BrownSpaceEngineering/PVDX-Comms-Hardware/Components/PCB.SMAFST.2H.A.HT/PCB.SMAFST.2H.A.HT.step

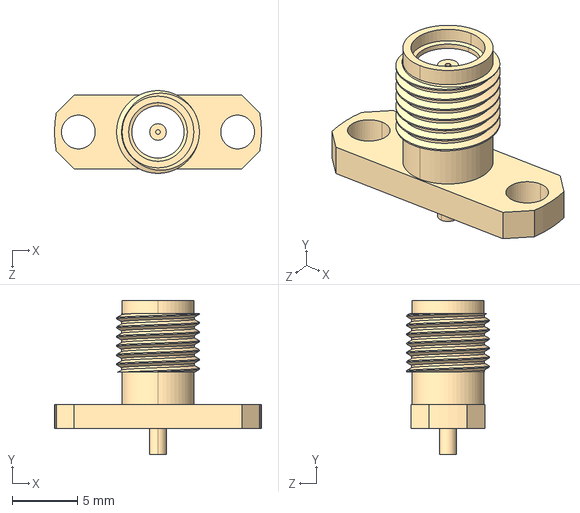
[picture p1: CAD file, 2026-09-30]
Components/PCB.SMAFST.2H.A.HT/PCB.SMAFST.2H.A.HT.step
15.9 x 11.8 x 6.35 mm
