BrownSpaceEngineering/PVDX-Comms-Hardware/Components/RBP-440+/SMD8_GP731_MNC.step

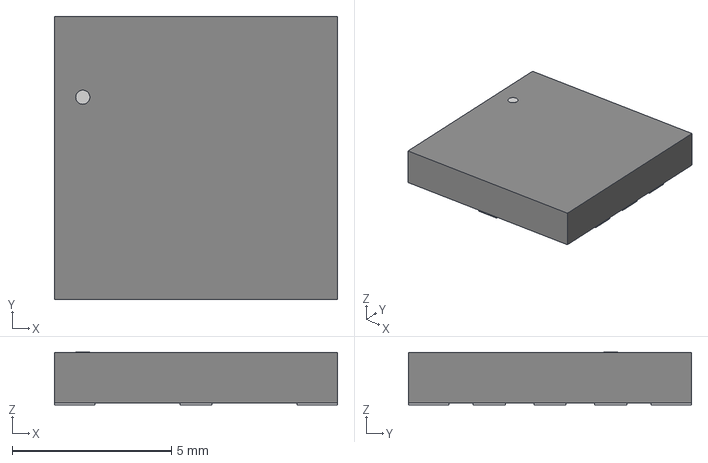
[picture p2: CAD file, 2026-10-01]
Components/RBP-440+/SMD8_GP731_MNC.step
8.89 x 8.89 x 1.65 mm
