BrownSpaceEngineering/PVDX-Comms-Hardware/AT86 Breakout/AT86 Breakout.pdf

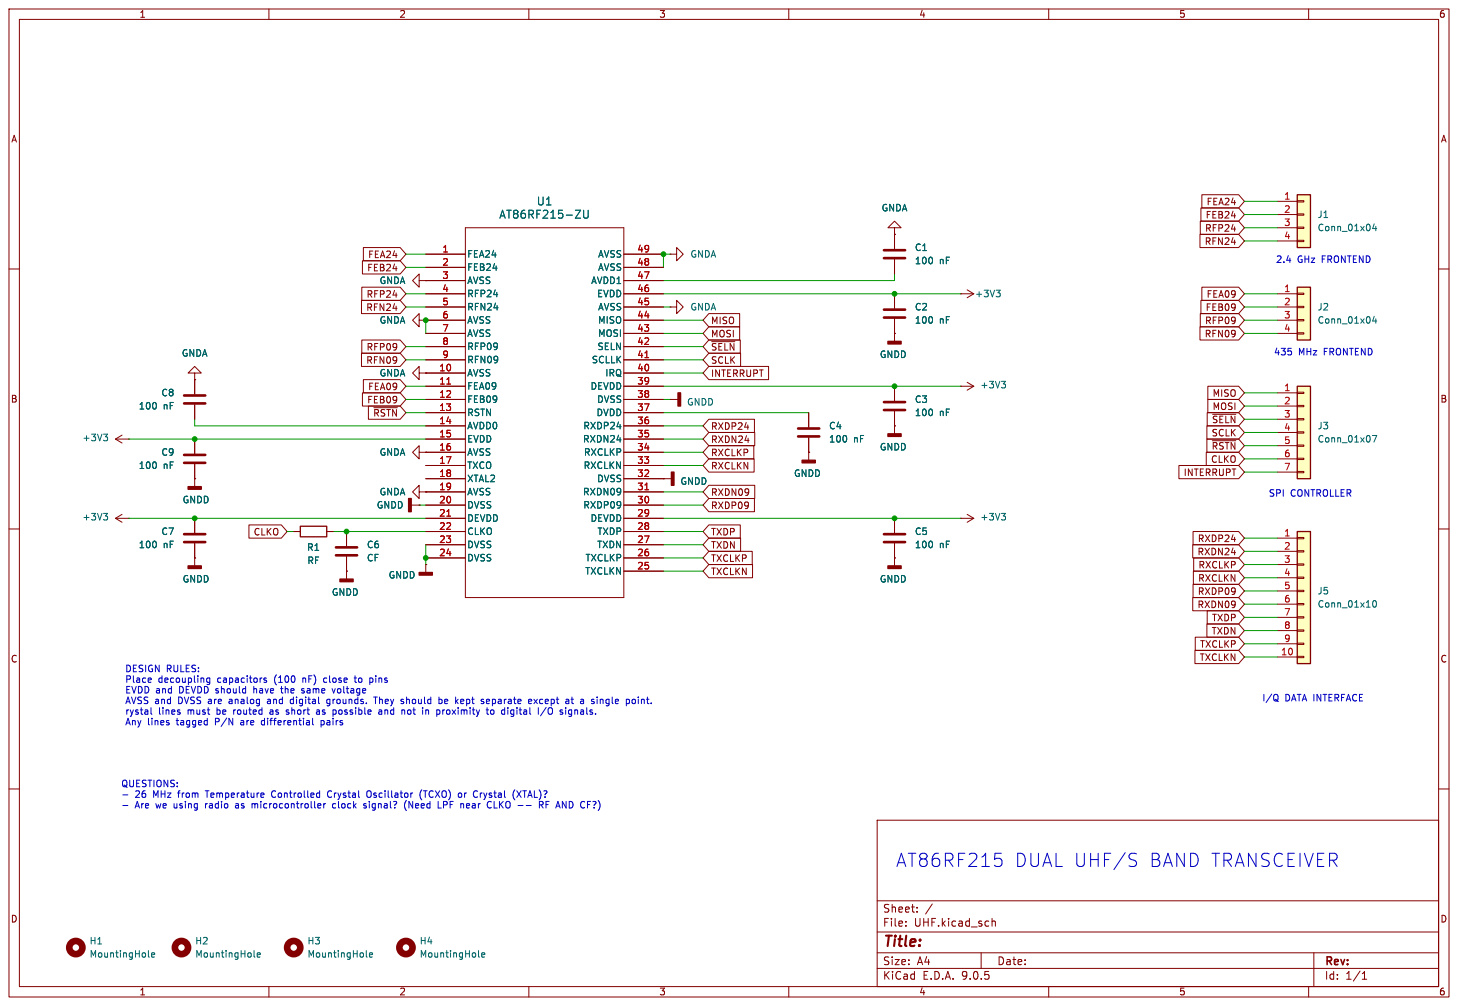
[picture p3: page 1]

100 nF GNDD GNDD U1 AT86RF215-ZU

RXDP09 MISO MOSI ~{SELN} SCLK

SPI CONTROLLER AT86RF215 DUAL UHF/S BAND TRANSCEIVER

Id: 1/1 Title: File: UHF.kicad_sch Sheet: /
