BrownSpaceEngineering/PVDX-Comms-Hardware/Unified UHF/Unified UHF.kicad_pcb

## KiCad design Unified UHF/Unified UHF.kicad_pcb (2026-10-05)

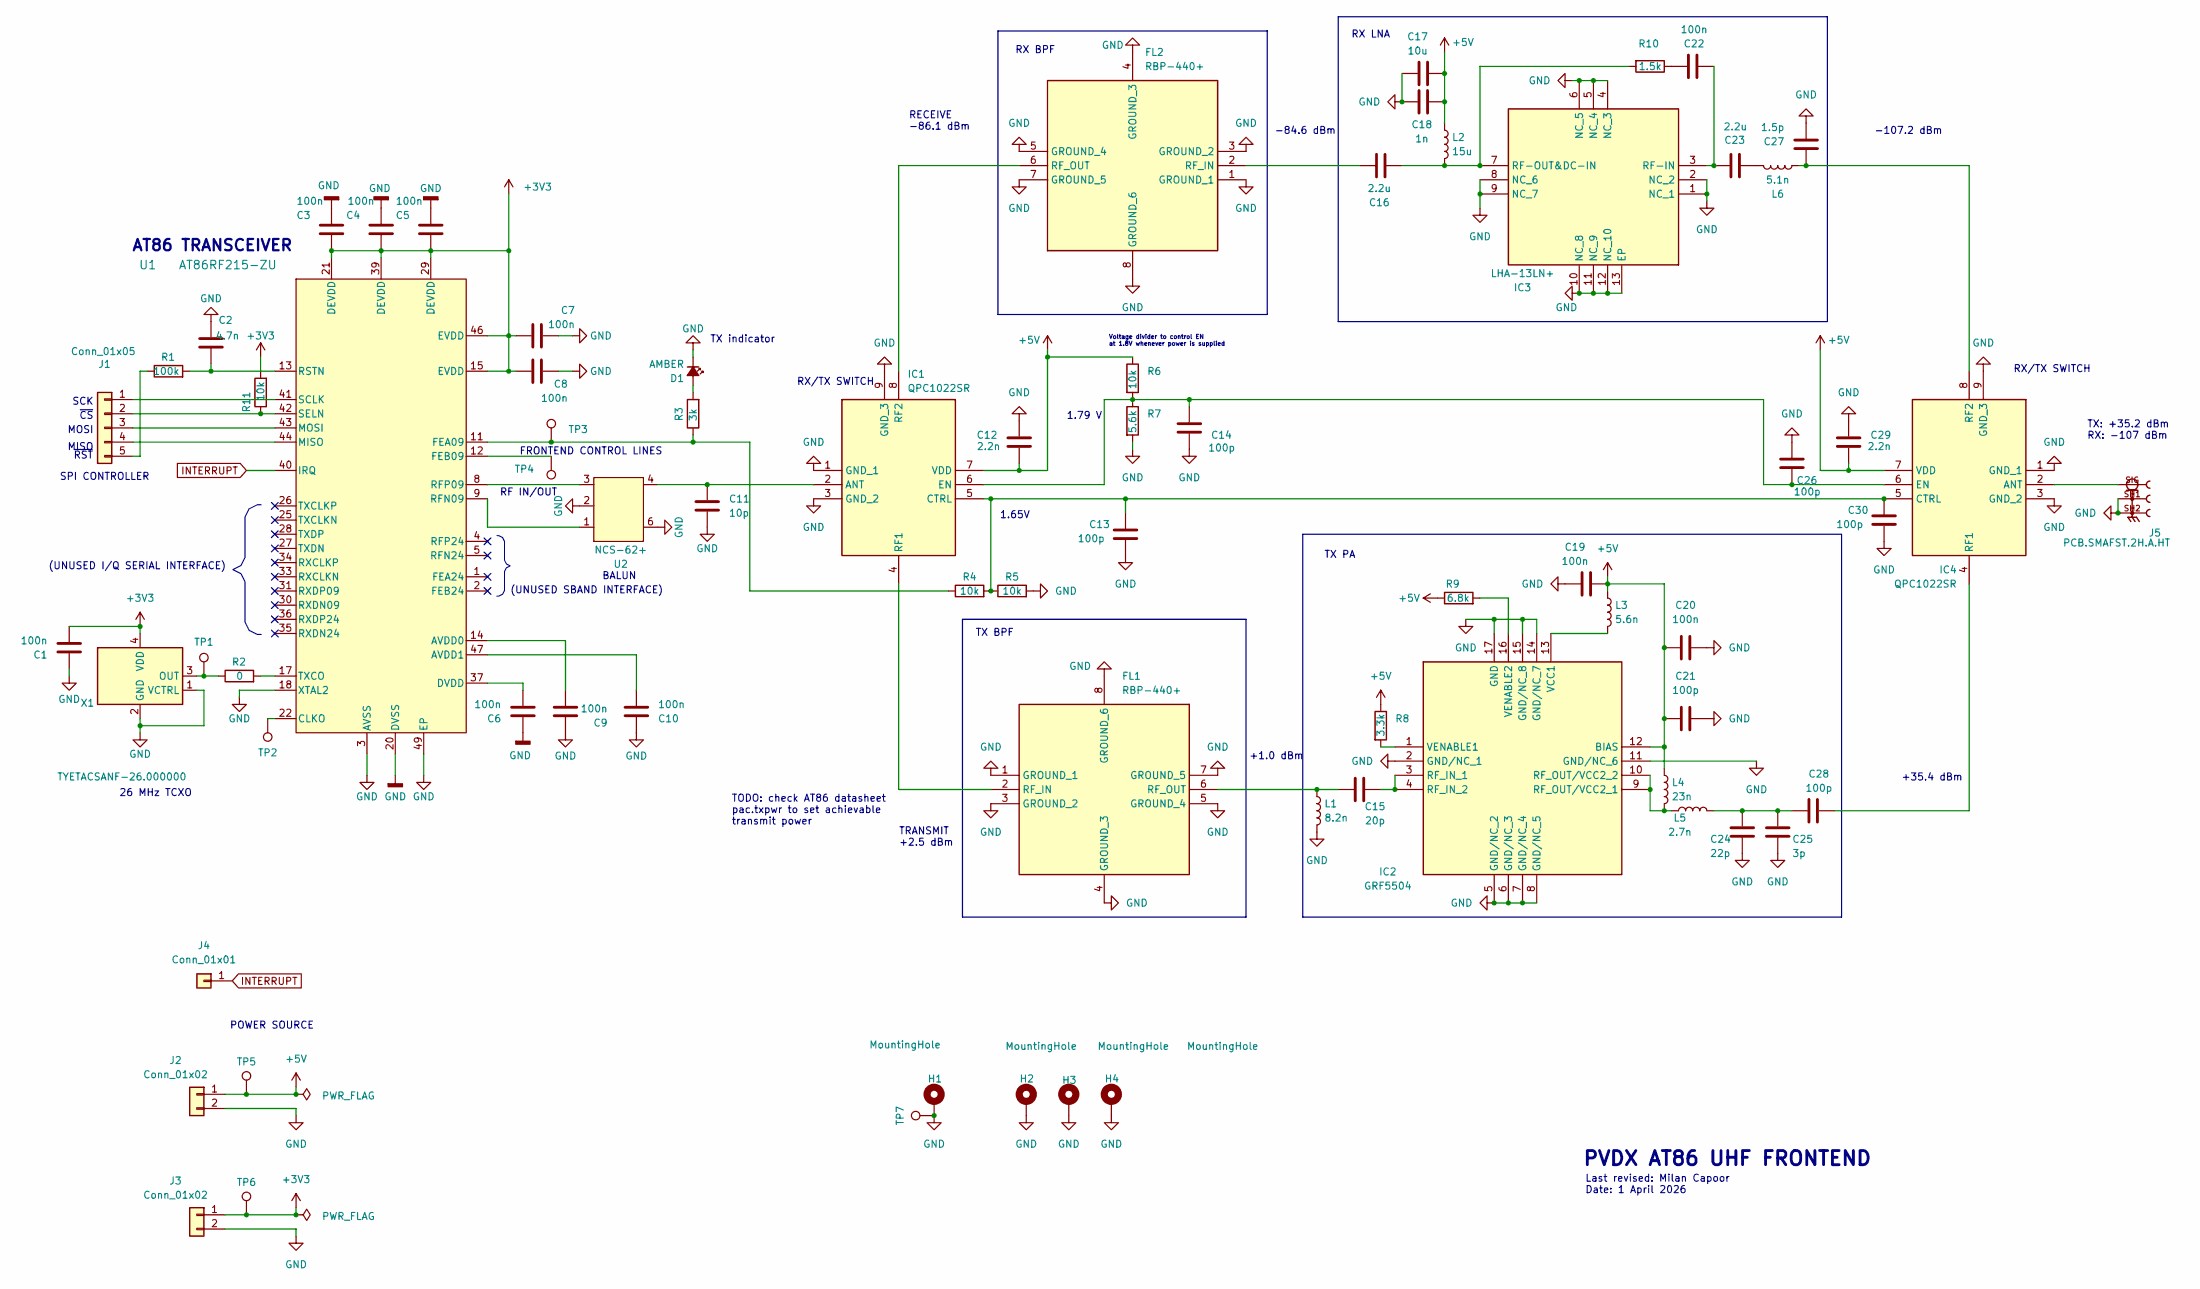
[picture p4: schematic Unified UHF.kicad_sch]

Parts:
C1, C3, C4, C5, C6, C7, C8, C9, C10, C19, C20, C22: 100n; C_0603_1608Metric
C2: 4.7n; C_0603_1608Metric
C11: 10p; C_0603_1608Metric
C12, C29: 2.2n; C_0603_1608Metric
C13, C14, C21, C26, C28, C30: 100p; C_0603_1608Metric
C15: 20p; C_0603_1608Metric
C16, C23: 2.2u; C_0603_1608Metric
C17: 10u; C_0805_2012Metric
C18: 1n; C_0603_1608Metric
C24: 22p; C_0603_1608Metric
C25: 3p; C_0603_1608Metric
C27: 1.5p; C_0603_1608Metric
D1: AMBER; LED_0603_1608Metric; MPN 150060AS75000
FL1, FL2: RBP-440+; RBP440; Mouser Part Number 139-RBP-440
H1, H2, H3, H4: MountingHole; MountingHole_3.4mm_Pad(edited from 3.5mm hole)
IC1, IC4: QPC1022SR; Mouser Part Number 772-QPC1022SR
IC2: GRF5504; GR5504; Mouser Part Number 459-GRF5504
IC3: LHA-13LN+; LHA13LN; Mouser Part Number 139-LHA-13LN
J1: Conn_01x05; PinSocket_1x05_P2.54mm_Vertical
J2, J3: Conn_01x02; PinSocket_1x02_P2.54mm_Vertical
J4: Conn_01x01; PinSocket_1x01_P2.54mm_Vertical
J5: PCB.SMAFST.2H.A.HT; TAOGLAS_PCB.SMAFST.2H.A.HT; PARTREV SPE-12-8-140/A/WY; DigiKey_Part_Number 931-1178-ND
L1: 8.2n; L_0603_1608Metric
L2: 15u; L_1210_3225Metric
L3: 5.6n; L_0805_2012Metric
L4: 23n; L_0805_2012Metric
L5: 2.7n; L_0603_1608Metric
L6: 5.1n; L_0603_1608Metric
R1: 100k; R_0603_1608Metric
R2: 0; R_0603_1608Metric
R3: 3k; R_0603_1608Metric
R4, R5, R6, R11: 10k; R_0603_1608Metric
R7: 5.6k; R_0603_1608Metric
R8: 3.3k; R_0603_1608Metric
R9: 6.8k; R_0603_1608Metric
R10: 1.5k; R_0603_1608Metric
TP1, TP2, TP3, TP4, TP5, TP6: TestPoint; TestPoint_Pad_D1.0mm
TP7: TestPoint; TestPoint_THTPad_D1.5mm_Drill0.7mm
U1: AT86RF215-ZU; AT86Footprint
U2: NCS-62+; NCS262
X1: TYETACSANF-26.000000; X_TCXO_SMD_Taitien_2.5x2.0mm; MPN TYETACSANF-26.000000

Connections:
+3V3: C1.2, C3.2, C4.2, C5.2, C7.2, C8.2, J3.1, R11.2, TP6.1 (1_1), U1.15 (EVDD), U1.21 (DEVDD), U1.29 (DEVDD), U1.39 (DEVDD), U1.46 (EVDD), X1.4 (VDD)
+5V: C12.1, C17.1, C18.1, C19.2, C20.1, C21.1, C29.1, IC1.7 (VDD), IC2.12 (BIAS), IC4.7 (VDD), J2.1, L2.1, L3.1, L4.1, R6.1, R8.1, R9.1, TP5.1 (1_1)
GND: C1.1, C2.1, C3.1, C4.1, C5.1, C6.1, C7.1, C8.1, C9.1, C10.1, C11.1, C12.2, C13.2, C14.2, C17.2, C18.2, C19.1, C20.2, C21.2, C24.2, C25.2, C26.2, C27.2, C29.2, C30.2, D1.1 (K), FL1.1 (GROUND_1), FL1.3 (GROUND_2), FL1.4 (GROUND_3), FL1.5 (GROUND_4), FL1.7 (GROUND_5), FL1.8 (GROUND_6), FL2.1 (GROUND_1), FL2.3 (GROUND_2), FL2.4 (GROUND_3), FL2.5 (GROUND_4), FL2.7 (GROUND_5), FL2.8 (GROUND_6), H1.1 (1_1), H2.1 (1_1), H3.1 (1_1), H4.1 (1_1), IC1.1 (GND_1), IC1.3 (GND_2), IC1.9 (GND_3), IC2.2 (GND/NC_1), IC2.5 (GND/NC_2), IC2.6 (GND/NC_3), IC2.7 (GND/NC_4), IC2.8 (GND/NC_5), IC2.11 (GND/NC_6), IC2.14 (GND/NC_7), IC2.15 (GND/NC_8), IC2.17 (GND), IC3.1 (NC_1), IC3.2 (NC_2), IC3.4 (NC_3), IC3.5 (NC_4), IC3.6 (NC_5), IC3.8 (NC_6), IC3.9 (NC_7), IC3.10 (NC_8), IC3.11 (NC_9), IC3.12 (NC_10), IC3.13 (EP), IC4.1 (GND_1), IC4.3 (GND_2), IC4.9 (GND_3), J2.2, J3.2, J5.SH1, J5.SH2, L1.2, R5.2, R7.2, TP7.1 (1_1), U1.3 (AVSS), U1.6 (AVSS), U1.7 (AVSS), U1.10 (AVSS), U1.16 (AVSS), U1.18 (XTAL2), U1.19 (AVSS), U1.20 (DVSS), U1.23 (DVSS), U1.24 (DVSS), U1.32 (DVSS), U1.38 (DVSS), U1.45 (AVSS), U1.48 (AVSS), U1.49 (EP), U2.2, U2.6, X1.1 (VCTRL), X1.2 (GND)
INTERRUPT: J4.1 (Pin_1_1), U1.40 (IRQ)
unnamed: C22.2, R10.1
unnamed: C23.1, L6.2
unnamed: C24.1, C25.1, C28.1, L5.2
unnamed: D1.2 (A), R3.2
unnamed: FL1.2 (RF_IN), IC1.4 (RF1)
unnamed: C15.1, FL1.6 (RF_OUT), L1.1
unnamed: C16.2, FL2.2 (RF_IN)
unnamed: FL2.6 (RF_OUT), IC1.8 (RF2)
unnamed: C11.2, IC1.2 (ANT), U2.4
unnamed: C13.1, C30.1, IC1.5 (CTRL), IC4.5 (CTRL), R4.2, R5.1
unnamed: C14.1, C26.1, IC1.6 (EN), IC4.6 (EN), R6.2, R7.1
unnamed: C15.2, IC2.3 (RF_IN_1), IC2.4 (RF_IN_2)
unnamed: IC2.9 (RF_OUT/VCC2_1), IC2.10 (RF_OUT/VCC2_2), L4.2, L5.1
unnamed: IC2.13 (VCC1), L3.2
unnamed: IC2.1 (VENABLE1), R8.2
unnamed: IC2.16 (VENABLE2), R9.2
unnamed: C22.1, C23.2, IC3.3 (RF-IN)
unnamed: C16.1, IC3.7 (RF-OUT&DC-IN), L2.2, R10.2
unnamed: IC4.2 (ANT), J5.SIG
unnamed: C28.2, IC4.4 (RF1)
unnamed: C27.1, IC4.8 (RF2), L6.1
unnamed: J1.1, U1.41 (SCLK)
unnamed: J1.2, R11.1, U1.42 (SELN)
unnamed: J1.3, U1.43 (MOSI)
unnamed: J1.4, U1.44 (MISO)
unnamed: J1.5, R1.1
unnamed: C9.2, U1.14 (AVDD0)
unnamed: C10.2, U1.47 (AVDD1)
unnamed: TP2.1 (1_1), U1.22 (CLKO)
unnamed: C6.2, U1.37 (DVDD)
unnamed: R3.1, R4.1, TP3.1 (1_1), U1.11 (FEA09)
unnamed: TP4.1 (1_1), U1.12 (FEB09)
unnamed: U1.9 (RFN09), U2.1
unnamed: U1.8 (RFP09), U2.3
unnamed: C2.2, R1.2, U1.13 (RSTN)
unnamed: R2.2, U1.17 (TXCO)
unnamed: R2.1, TP1.1 (1_1), X1.3 (OUT)

Notes on the sheet:
SCK
(UNUSED SBAND INTERFACE)
MISO
TX PA
RX BPF
~{CS}
FRONTEND CONTROL LINES
RX/TX SWITCH
BALUN
SPI CONTROLLER
TRANSMIT +2.5 dBm
TX BPF
+35.4 dBm
-107.2 dBm
-84.6 dBm
1.65V
~{RST}
TX indicator
TODO: check AT86 datasheet pac.txpwr to set achievable transmit power
1.79 V
RF IN/OUT
RECEIVE -86.1 dBm
Last revised: Milan Capoor Date: 1 April 2026
RX LNA
26 MHz TCXO
Voltage divider to control EN at 1.8V whenever power is supplied
(UNUSED I/Q SERIAL INTERFACE)
+1.0 dBm
AT86 TRANSCEIVER
MOSI
PVDX AT86 UHF FRONTEND
POWER SOURCE
TX: +35.2 dBm RX: -107 dBm

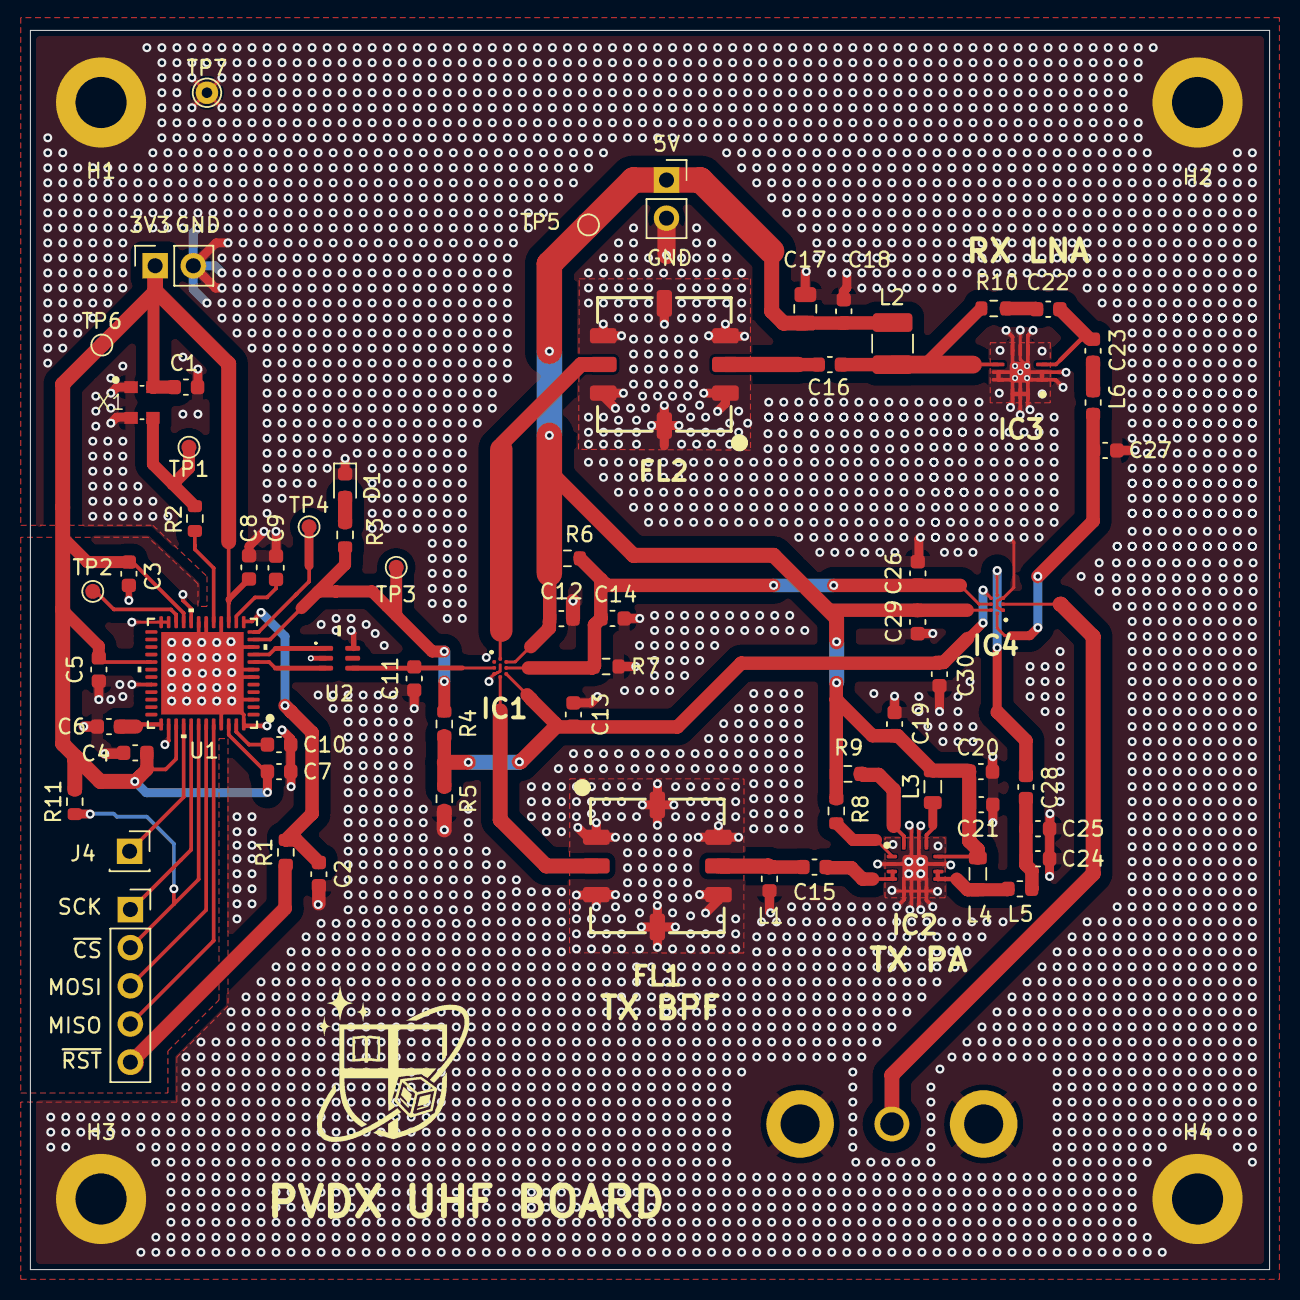
[picture p5: board Unified UHF.kicad_pcb from above]

Board: 2 copper layers, 82.5 x 82.5 mm, 73 parts (1 on the bottom side), 41 nets.
