BrownSpaceEngineering/PVDX-Comms-Hardware/(commit log)

2025-11-23 Initial schematic from datasheet
    [AT86 Breakout.kicad_pcb, AT86 Breakout.kicad_sch]
2026-04-01 rf frontend schematic initial commit
    [RF Frontend Breakout.kicad_pcb, RF Frontend Breakout.kicad_sch]
2026-04-19 initial frontend layout
    [AT86 Breakout.kicad_sch, RF Frontend Breakout.kicad_pcb, RF Frontend Breakout.kicad_sch]
2026-05-03 finished pcb
    [RF Frontend Breakout.kicad_pcb, RF Frontend Breakout.kicad_sch]
2026-05-07 small changes after larry meeting will populate his changes later
    [RF Frontend Breakout.kicad_pcb]
2026-05-10 added groundplate to BPF and vias
    [RF Frontend Breakout.kicad_pcb]
2026-05-21 brought power traces to front
    [RF Frontend Breakout.kicad_pcb]
2026-07-31 finished frontend layout!
    [RF Frontend Breakout.kicad_pcb, RF Frontend Breakout.kicad_sch, RF Frontend Breakout.recovered.2026-07-31_165946.kicad_pcb, Unified UHF.kicad_pcb, Unified UHF.kicad_sch]
2026-08-01 added unified radio schematic
    [AT86 Breakout.kicad_sch, AT86 Breakout.recovered.2026-02-22_222905.kicad_sch, Unified UHF.kicad_pcb, Unified UHF.recovered.2026-08-01_163820.kicad_sch, frontend.kicad_sch]
2026-08-02 small tweaks on unified board
    [AT86 Breakout 8:1:26.kicad_sch, RF Frontend Breakout 8:1:26.kicad_sch, Unified UHF.kicad_sch]
2026-08-06 Rename AT86 Breakout 8:1:26.kicad_sch to AT86 Breakout080126.kicad_sch
    fix filename 01
    [AT86 Breakout080126.kicad_sch]
2026-08-06 Rename RF Frontend Breakout 8:1:26.kicad_sch to RF Frontend Breakout080126.kicad_sch
    fix filename 02
    [RF Frontend Breakout080126.kicad_sch]
2026-08-08 removed lin regulator
    [UHF_frontend_bom.csv, Unified UHF.kicad_sch]
2026-08-15 unified pcb finished minus screws and via overlay
    [RF Frontend Breakout.kicad_pcb, RF Frontend Breakout.kicad_sch, RF Frontend Breakout.recovered.2026-07-31_165946.kicad_pcb, Unified UHF copy.kicad_sch]
2026-08-15 saving first
    [RF Frontend Breakout.kicad_pcb]
2026-08-15 small fixes
    [RF Frontend Breakout.kicad_pcb]
2026-08-16 mounting holes + design checker fixes
    [RF Frontend Breakout.kicad_pcb, RF Frontend Breakout.kicad_sch]
2026-08-17 added via overlay
    [RF Frontend Breakout.kicad_pcb]
2026-09-30 fixed PA traces
    [RF Frontend Breakout.kicad_pcb, RF Frontend Breakout.kicad_sch, RF Frontend Breakout_from_schematic.csv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]
2026-09-30 removed unnecessary files
    [AT86 Breakout080126.kicad_sch, RF Frontend Breakout.recovered.2026-07-31_165946.kicad_pcb, RF Frontend Breakout080126.kicad_sch, RF Frontend Breakout_from_schematic.csv, UHF_frontend_bom.csv, Unified UHF copy.kicad_sch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]
2026-09-30 fixed schematic as well
    [RF Frontend Breakout.kicad_pcb, RF Frontend Breakout.kicad_sch]
2026-09-30 Fixed layout (minus new coax)
    [PCB.SMAFST.2H.A.HT.step, RF Frontend Breakout.kicad_pcb, RF Frontend Breakout.kicad_sch, Unified UHF.kicad_pcb, Unified UHF.kicad_sch]
2026-09-30 small changes
    [Unified UHF.kicad_pcb, Unified UHF.kicad_sch]
2026-09-30 Routed coax
    [Unified UHF.kicad_pcb, Unified UHF.kicad_sch]
2026-10-01 added connector, changed connection to under paddle, other neurotic fixes
    [Unified UHF.kicad_pcb]
2026-10-01 small change
    [Unified UHF.kicad_pcb]
2026-10-01 generated STEP, make gitignore, add 3dmodels
    [SMD8_GP731_MNC.step]
2026-10-01 design review, 3d models, silkscreen fix
    [Unified UHF.kicad_pcb]
2026-10-01 Clean repo: untrack KiCad backups/autosaves/lock/OS files, fix .gitignore
    [AT86 Breakout.recovered.2026-02-22_222905.kicad_sch, RF Frontend Breakout.recovered.2026-07-31_165946.kicad_pcb]
2026-10-03 fixes fixes
    [Unified UHF.kicad_pcb, Unified UHF.kicad_sch]
2026-10-04 pad sizing, vias, checking things, etc
    [Unified UHF.kicad_pcb]
2026-10-04 before updating from schematic - as for as I know this is good
    [Unified UHF-B_Cu.gbr, Unified UHF-B_Mask.gbr, Unified UHF-B_Paste.gbr, Unified UHF-B_Silkscreen.gbr, Unified UHF-Edge_Cuts.gbr, Unified UHF-F_Cu.gbr, Unified UHF-F_Mask.gbr, Unified UHF-F_Paste.gbr]
2026-10-05 done prob
    [Unified UHF-B_Cu.gbr, Unified UHF-B_Mask.gbr, Unified UHF-B_Paste.gbr, Unified UHF-B_Silkscreen.gbr, Unified UHF-Edge_Cuts.gbr, Unified UHF-F_Cu.gbr, Unified UHF-F_Mask.gbr, Unified UHF-F_Paste.gbr]
2026-10-05 finally done
    [Unified UHF-B_Cu.gbr, Unified UHF-B_Mask.gbr, Unified UHF-B_Paste.gbr, Unified UHF-B_Silkscreen.gbr, Unified UHF-Edge_Cuts.gbr, Unified UHF-F_Cu.gbr, Unified UHF-F_Mask.gbr, Unified UHF-F_Paste.gbr]
2026-10-05 small pcbway tweaks
    [Unified UHF-B_Cu.gbr, Unified UHF-B_Mask.gbr, Unified UHF-B_Paste.gbr, Unified UHF-B_Silkscreen.gbr, Unified UHF-Edge_Cuts.gbr, Unified UHF-F_Cu.gbr, Unified UHF-F_Mask.gbr, Unified UHF-F_Paste.gbr]
